efabless/raptor/hardware/raptor_back.jpg

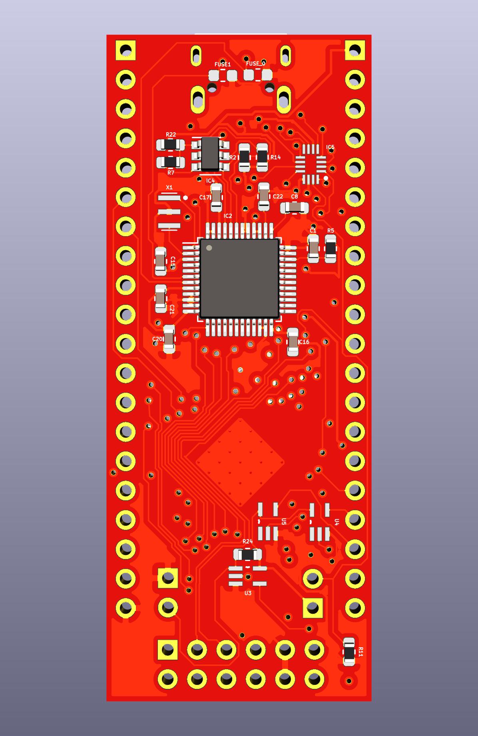
hardware/raptor_back.jpg
