efabless/raptor/hardware/raptor_front.jpg

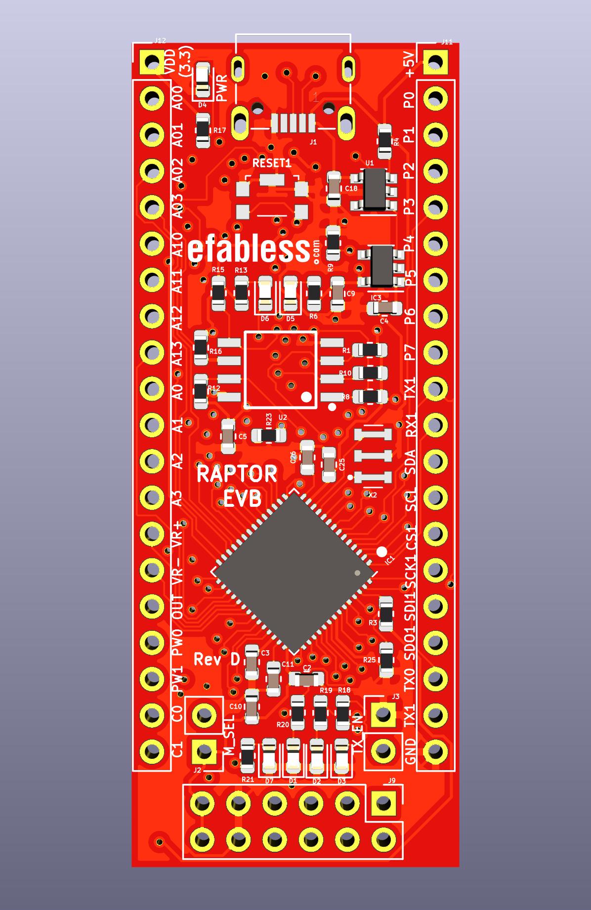
hardware/raptor_front.jpg
