efabless/raptor/hardware/raptor.xlsx

Reference | Quantity | Value | MPN | Vendor | Digikey PN | Link | Footprint
C1 | 1 | 10nf | UMK107B7103KAHT | Taiyo Yuden | 587-5957-1-ND | https://www.digikey.com/product-detail/en/taiyo-yuden/UMK107B7103KAHT/587-5957-1-ND/7675077 | Capacitor_SMD:C_0603_1608Metric
C15 C16 C17 C20 C21 C8 C22 C5 C25 C26 C10 C11 C3 C2 | 14 | 0.1uf | LMF107B7104KAHT | Taiyo Yuden | 587-6557-1-ND | https://www.digikey.com/products/en/capacitors/ceramic-capacitors/60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 | Capacitor_SMD:C_0603_1608Metric
C4 C9 C18 | 3 | 1uf | LMK107C6105KA-T | Taiyo Yuden | 587-4912-1-ND | https://www.digikey.com/product-detail/en/taiyo-yuden/LMK107C6105KA-T/587-4912-1-ND/6563755 | Capacitor_SMD:C_0603_1608Metric
D4 D3 D2 D1 D7 D6 D5 | 7 | LED | 150060RS55040 | Würth Elektronik | 732-12015-1-ND | https://www.digikey.com/products/en?keywords=732-12015-1-ND | LED_SMD:LED_0603_1608Metric
FUSE_0 FUSE1 | 2 | PGB10100603 | PGB1010603NRHF | Littelfuse Inc. | F4239CT-ND | https://www.digikey.com/products/en?keywords=F4239CT-ND | Fuse:Fuse_0603_1608Metric
IC1 | 1 | RAPTORQFN56 | Raptor | Efabless |  |  | Package_DFN_QFN:QFN-56-1EP_8x8mm_P0.5mm_EP5.6x5.6mm_ThermalVias
IC2 | 1 | FT232H | FT232HL-REEL | FTDI, Future Technology Devices International Ltd | 768-1101-1-ND | https://www.digikey.com/product-detail/en/ftdi-future-technology-devices-international-ltd/FT232HL-REEL/768-1101-1-ND/2614632 | Package_QFP:LQFP-48_7x7mm_P0.5mm
IC3 | 1 | MCP1755 | MCP1755T-3302E/OT | Microchip Technology | MCP1755T-3302E/OTCT-ND | https://www.digikey.com/products/en?keywords=MCP1755T-3302E%2FOTCT-ND | Package_TO_SOT_SMD:SOT-23-5
IC4 | 1 | 93C56 | 93C56BT-I/OT | Microchip Technology | 93C56BT-I/OTCT-ND | https://www.digikey.com/products/en?keywords=93C56BT-I%2FOTCT-ND | Package_TO_SOT_SMD:SOT-23-6
IC5 | 1 |  | TMUX1574RSVR | Texas Instruments | 296-53445-1-ND | https://www.digikey.com/products/en/integrated-circuits-ics/interface-analog-switches-multiplexers-demultiplexers/747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 | SamacSys_Parts:QFN40P180X260X55-16N
J1 | 1 | USB | 629105150521 | Würth Elektronik | 732-5960-1-ND | https://www.digikey.com/product-detail/en/w%C3%BCrth-elektronik/629105150521/732-5960-1-ND/5047555 | parts and footprints:629105150521
J11 J12 | 0 | CONN_20 | 68000-220HLF | Amphenol ICC (FCI) | 609-5100-ND | https://www.digikey.com/product-detail/en/amphenol-icc-fci/68000-220HLF/609-5100-ND/4273250 | Connector_PinHeader_2.54mm:PinHeader_1x20_P2.54mm_Vertical
J2 J3 | 0 | Conn_01x02_Male | 77311-118-02LF | Amphenol ICC (FCI) | 609-4434-ND | https://www.digikey.com/product-detail/en/amphenol-icc-fci/77311-118-02LF/609-4434-ND/1523689 | Connector_PinHeader_2.54mm:PinHeader_1x02_P2.54mm_Vertical
J9 | 0 | 2X6 FEMALE | PPPC062LJBN-RC | Sullins Connector Solutions | S5559-ND | https://www.digikey.com/product-detail/en/sullins-connector-solutions/PPPC062LJBN-RC/S5559-ND/776017 | Connector_PinHeader_2.54mm:PinHeader_2x06_P2.54mm_Vertical
R1 R12 R3 R4 R5 R10 R8 R11 R15 R16 R24 | 11 | 10K | ERJ-3EKF1002V | Panasonic Electronic Components | P10.0KHCT-ND | https://www.digikey.com/product-detail/en/panasonic-electronic-components/ERJ-3EKF1002V/P10-0KHCT-ND/198102 | Resistor_SMD:R_0603_1608Metric
R17 R18 R19 R20 R21 R13 R6 | 7 | 150 | RC0603FR-07150RL | Yageo | 311-150HRCT-ND | https://www.digikey.com/product-detail/en/yageo/RC0603FR-07150RL/311-150HRCT-ND/729905 | Resistor_SMD:R_0603_1608Metric
R22 R14 R2 | 3 | 10k | ERJ-3EKF1002V | Panasonic Electronic Components | P10.0KHCT-ND | https://www.digikey.com/product-detail/en/panasonic-electronic-components/ERJ-3EKF1002V/P10-0KHCT-ND/198102 | Resistor_SMD:R_0603_1608Metric
R23 R25 | 2 | 0 | ERJ-3GEY0R00V | Panasonic Electronic Components | P0.0GCT-ND | https://www.digikey.com/products/en/resistors/chip-resistor-surface-mount/52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 | Resistor_SMD:R_0603_1608Metric
R7 | 1 | 2K 1% | ERJ-3EKF2001V | Panasonic Electronic Components | P2.00KHCT-ND | https://www.digikey.com/product-detail/en/panasonic-electronic-components/ERJ-3EKF2001V/P2-00KHCT-ND/198219 | Resistor_SMD:R_0603_1608Metric
R9 | 1 | 12K 1% | ERJ-3EKF1202V | Panasonic Electronic Components | P12.0KHCT-ND | https://www.digikey.com/product-detail/en/panasonic-electronic-components/ERJ-3EKF1202V/P12-0KHCT-ND/1746728 | Resistor_SMD:R_0603_1608Metric
RESET1 | 1 | SPST-SMD-4.6X2.8mm | KMR421G LFS | C&K | CKN10249CT-ND | https://www.digikey.com/product-detail/en/c-k/KMR421G-LFS/CKN10249CT-ND/2176500 | SamacSys_Parts:TL6330AF200Q
U1 | 1 | MCP1316M | MCP1316MT-20LI/OT | Microchip Technology | MCP1316MT-20LI/OTCT-ND | https://www.digikey.com/products/en?keywords=MCP1316MT-20LI%2FOTCT-ND | Package_TO_SOT_SMD:SOT-23-5
U2 | 1 | W25Q32FV | W25Q32JVSSIQ TR | Winbond Electronics | W25Q32JVSSIQCT-ND | https://www.digikey.com/products/en?keywords=W25Q32JVSSIQCT-ND | parts and footprints:SOIC127P790X216-8N
U3 | 1 |  | SN74LVC1G125DCKR | Texas Instruments | 296-11604-1-ND | https://www.digikey.com/products/en/integrated-circuits-ics/logic-buffers-drivers-receivers-transceivers/704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
U4, U5 | 2 |  | SN74LV1T34DCKR | Texas Instruments | 296-37177-1-ND
X1 | 1 | 12MHz | CSTNE12M0GH5L000R0 | Murata Electronics | 490-17947-1-ND | https://www.digikey.com/products/en/crystals-oscillators-resonators/resonators/174?k=CSTNE12M0GH5L000R0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 | SamacSys_Parts:CSTNE12M0GH5L000R0
X2 | 1 | 6.25 MHz | CSTCR6M25G55B-R0 | Murata Electronics
