efabless/raptor/hardware/raptor.pdf

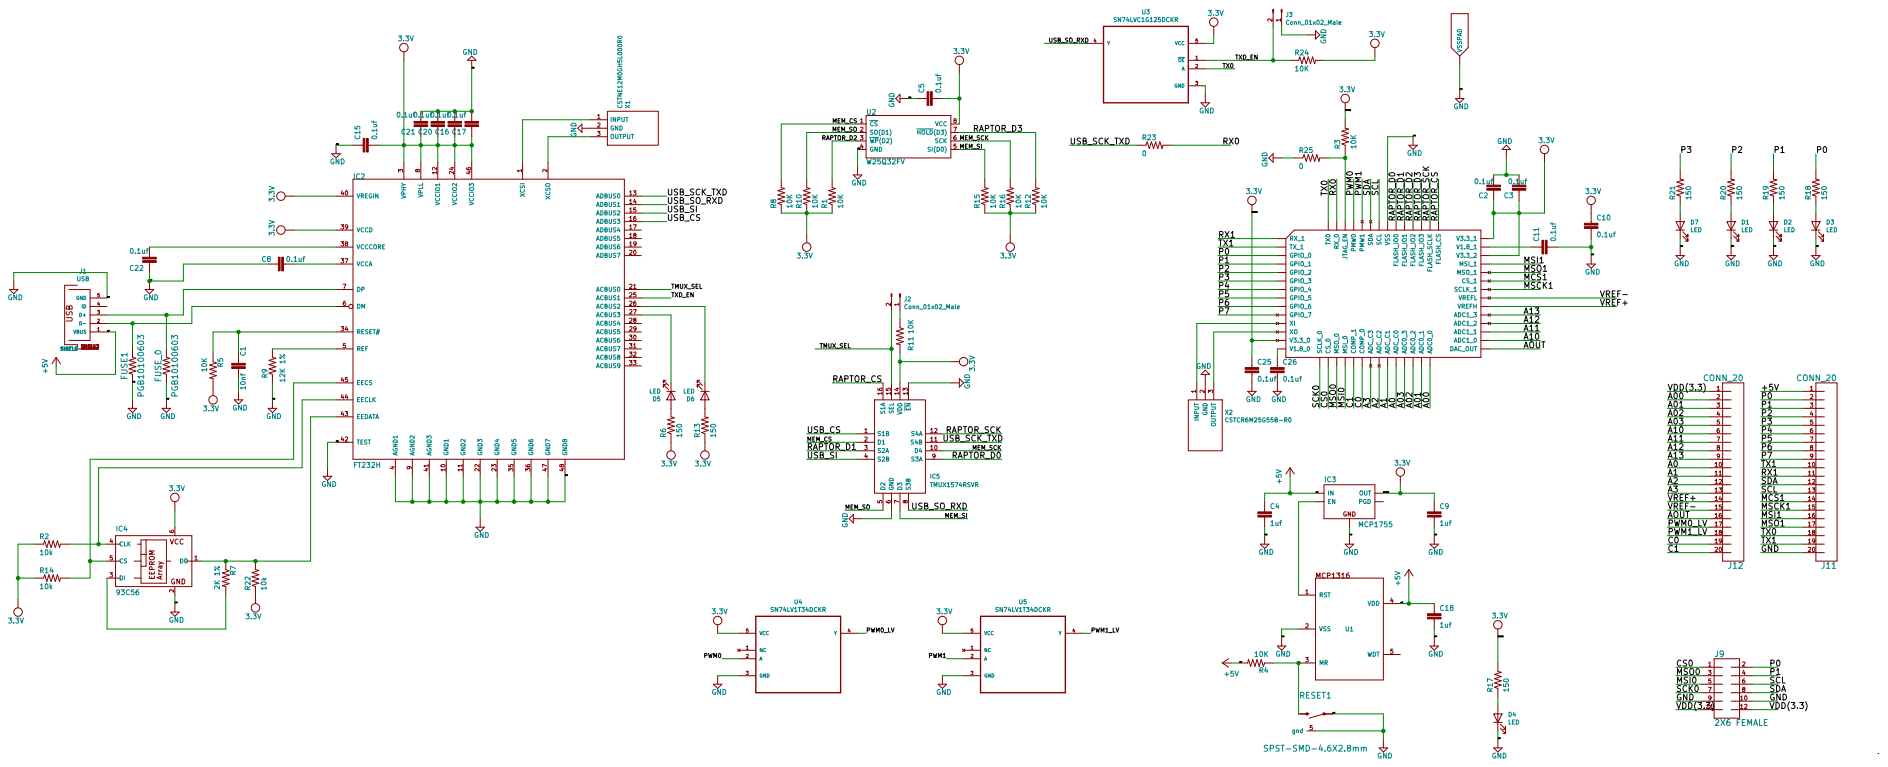
[picture p4: page 1]

4 VREGIN 40 AGND3 41 TEST 42 EEDATA 43 EECLK 44 EECS 45 VCCIO3 46 GND7 47 GND8 48 REF 5 DM 6 DP 7 VPLL

3 ACBUS6 30 ACBUS7 31 ACBUS8 32 ACBUS9 33 RESET# 34 GND5 35 GND6 36 VCCA 37 VCCCORE 38 VCCD 39 AGND1
