efabless/raptor/hardware/raptor.kicad_pcb

## KiCad design hardware/raptor.kicad_pcb (2020-08-08)

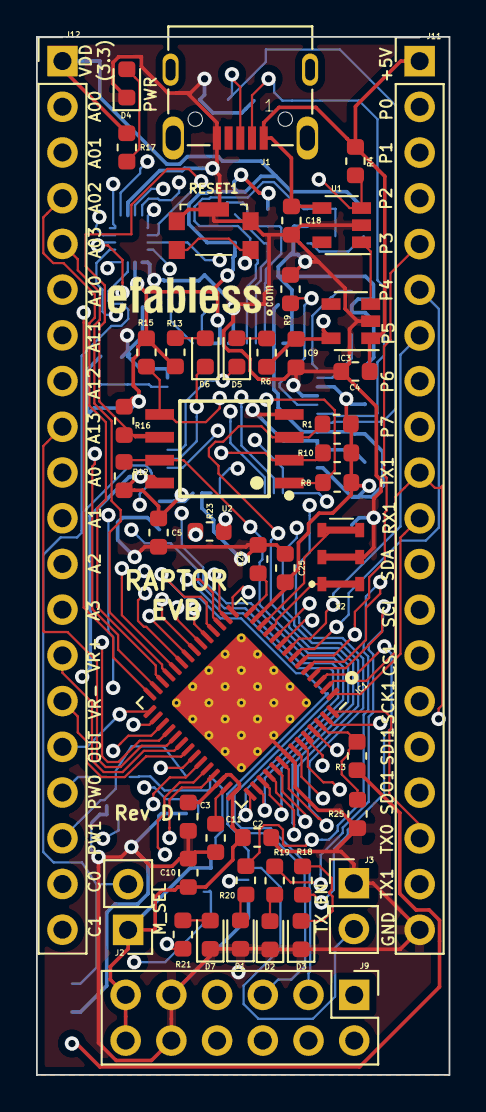
[picture p5: board raptor.kicad_pcb from above]

Board: 4 copper layers, 22.9 x 57.7 mm, 72 parts (0 on the bottom side), 91 nets.

Parts:
C1: 10nf; C_0603_1608Metric
C2, C3, C5, C8, C10, C11, C15, C16, C17, C20, C21, C22, C25, C26: 0.1uf; C_0603_1608Metric
C4, C9, C18: 1uf; C_0603_1608Metric
D1, D2, D3, D4, D5, D6, D7: LED; LED_0603_1608Metric
FUSE1: PGB10100603; Fuse_0603_1608Metric
FUSE_0: PGB10100603; Fuse_0603_1608Metric
G1: LOGO; logo
IC1: RAPTORQFN56; QFN-56-1EP_8x8mm_P0.5mm_EP5.6x5.6mm_ThermalVias
IC2: FT232H; LQFP-48_7x7mm_P0.5mm
IC3: MCP1755; SOT-23-5
IC4: 93C56; SOT-23-6
IC5: TMUX1574RSVR; QFN40P180X260X55-16N
J1: USB; 629105150521
J2, J3: Conn_01x02_Male; PinHeader_1x02_P2.54mm_Vertical
J9: 2X6 FEMALE; PinHeader_2x06_P2.54mm_Vertical
J11, J12: CONN_20; PinHeader_1x20_P2.54mm_Vertical
R1, R3, R4, R5, R8, R10, R11, R12, R15, R16, R24: 10K; R_0603_1608Metric
R2, R14, R22: 10k; R_0603_1608Metric
R6, R13, R17, R18, R19, R20, R21: 150; R_0603_1608Metric
R7: 2K 1%; R_0603_1608Metric
R9: 12K 1%; R_0603_1608Metric
R23, R25: 0; R_0603_1608Metric
RESET1: SPST-SMD-4.6X2.8mm; TL6330AF200Q
U1: MCP1316M; SOT-23-5
U2: W25Q32FV; SOIC127P790X216-8N
U3: SN74LVC1G125DCKR; SOT65P210X110-5N
U4, U5: SN74LV1T34DCKR; SOT65P210X110-5N
X1: CSTNE12M0GH5L000R0
X2: CSTCR6M25G55B-R0; CSTCR6M25G55BR0

Connections:
+5V: C4.1, C18.1, IC3.1, J1.1, J11.1, R4.2, U1.4
/A00: IC1.28, J12.2
/A0: IC1.24, J12.10
/A01: IC1.27, J12.3
/A1: IC1.23, J12.11
/A02: IC1.26, J12.4
/A2: IC1.22, J12.12
/A03: IC1.25, J12.5
/A3: IC1.21, J12.13
/A10: IC1.30, J12.6
/A11: IC1.31, J12.7
/A12: IC1.32, J12.8
/A13: IC1.33, J12.9
/AOUT: IC1.29, J12.16
/C0: IC1.20, J12.19
/C1: IC1.19, J12.20
/CS0: IC1.16, J9.1
/MCS1: IC1.37, J11.14
/MEM_CS: IC5.2, R8.2, U2.1
/MEM_SCK: IC5.10, R16.2, U2.6
/MEM_SI: IC5.7, R15.2, U2.5
/MEM_SO: IC5.5, R10.2, U2.2
/MSCK1: IC1.36, J11.15
/MSI0: IC1.18, J9.5
/MSI1: IC1.39, J11.16
/MSO0: IC1.17, J9.3
/MSO1: IC1.38, J11.17
/P0: IC1.3, J9.2, J11.2, R18.2
/P1: IC1.4, J9.4, J11.3, R19.2
/P2: IC1.5, J11.4, R20.2
/P3: IC1.6, J11.5, R21.2
/P4: IC1.7, J11.6
/P5: IC1.8, J11.7
/P6: IC1.9, J11.8
/P7: IC1.10, J11.9
/PWM0: IC1.53, U4.2
/PWM0_LV: J12.17, U4.4
/PWM1: IC1.52, U5.2
/PWM1_LV: J12.18, U5.4
/RAPTOR_CS: IC1.43, IC5.16
/RAPTOR_D0: IC1.48, IC5.9
/RAPTOR_D1: IC1.47, IC5.3
/RAPTOR_D2: IC1.46, R1.2, U2.3
/RAPTOR_D3: IC1.45, R12.2, U2.7
/RAPTOR_SCK: IC1.44, IC5.12
/RX0: IC1.55, R23.2
/RX1: IC1.1, J11.11
/SCK0: IC1.15, J9.7
/SCL: IC1.50, J9.6, J11.13
/SDA: IC1.51, J9.8, J11.12
/TMUX_SEL: IC2.21, IC5.15, J2.2, R11.1
/TX0: IC1.56, J11.18, U3.2
/TX1: IC1.2, J11.10, J11.19
/TXD_EN: IC2.25, J3.2, R24.1, U3.1
/USB_CS: IC2.16, IC5.1
/USB_SCK_TXD: IC2.13, IC5.11, R23.1
/USB_SI: IC2.15, IC5.4
/USB_SO_RXD: IC2.14, IC5.8, U3.4
/VREF+: IC1.34, J12.14
/VREF-: IC1.35, J12.15
GND: C1.2, C2.2, C3.2, C4.2, C5.1, C8.1, C9.2, C10.2, C11.2, C15.1, C16.2, C17.2, C18.2, C20.2, C21.2, C22.1, C25.2, C26.2, D1.1, D2.1, D3.1, D4.1, D7.1, FUSE1.1, FUSE_0.1, IC1.49, IC1.57, IC2.4, IC2.9, IC2.10, IC2.11, IC2.22, IC2.23, IC2.35, IC2.36, IC2.41, IC2.42, IC2.47, IC2.48, IC3.2, IC4.2, IC5.6, IC5.13, J1.5, J3.1, J9.9, J9.10, J11.20, R9.1, R11.2, R25.1, RESET1.1, RESET1.2, RESET1.5, U1.2, U2.4, U3.3, U4.3, U5.3, X1.2, X2.2
unnamed: C1.1, IC2.34, R5.1
unnamed: C8.2, IC2.37
unnamed: C11.1, IC1.41
unnamed: C22.2, IC2.38
unnamed: C26.1, IC1.14
unnamed: D1.2, R20.1
unnamed: D2.2, R19.1
unnamed: D3.2, R18.1
unnamed: D4.2, R17.1
unnamed: D5.1, IC2.27
unnamed: D5.2, R6.2
unnamed: D6.1, IC2.26
unnamed: D6.2, R13.2
unnamed: D7.2, R21.1
unnamed: FUSE1.2, IC2.6, J1.2
unnamed: FUSE_0.2, IC2.7, J1.3
unnamed: IC1.11, X2.1
unnamed: IC1.12, X2.3
unnamed: IC1.54, R3.1, R25.2
unnamed: IC2.1, X1.1
unnamed: IC2.2, X1.3
unnamed: IC2.5, R9.2
unnamed: IC2.43, IC4.1, R7.1, R22.2
unnamed: IC2.44, IC4.4, R2.2
unnamed: IC2.45, IC4.5, R14.2
unnamed: IC3.3, U1.1
unnamed: IC4.3, R7.2
unnamed: J1.SHELL, J1.SHELL1, J1.SHELL2, J1.SHELL3
unnamed: R4.1, RESET1.3, RESET1.4, U1.3
VDD: C2.1, C3.1, C5.2, C9.1, C10.1, C15.2, C16.1, C17.1, C20.1, C21.1, C25.1, IC1.13, IC1.40, IC1.42, IC2.3, IC2.8, IC2.12, IC2.24, IC2.39, IC2.40, IC2.46, IC3.5, IC4.6, IC5.14, J2.1, J9.11, J9.12, J12.1, R1.1, R2.1, R3.2, R5.2, R6.1, R8.1, R10.1, R12.1, R13.1, R14.1, R15.1, R16.1, R17.2, R22.1, R24.2, U2.8, U3.5, U4.5, U5.5
