efabless/raptor/firmware/i2c/i2c.c

#include "../raptor.h"
#include "../raptor_io.h"

#define BCD_DIGIT0(x) (x & (uint32_t)0x000F)
#define BCD_DIGIT1(x) ((x >> 4) & (uint32_t)0x000F)

#define RTC_I2C_ADDR (uint32_t) 0xA2 // RTC PCF8563
#define RTC_I2C_REG (uint32_t) 0x02 // RTC PCF8563

//#define RTC_I2C_ADDR (uint32_t)0xD0 // RTC DS3231
//#define RTC_I2C_REG (uint32_t) 0x00 // RTC DS3231

//#define RTC_I2C_ADDR (uint32_t) 0xDE // RTC MCP79410
//#define RTC_I2C_REG (uint32_t) 0x00 // RTC MCP79410

//unsigned char data[4];


void main()
{
//	uint32_t i, j;
	int i, j;
	int x, v, y;
    unsigned char data[2];

//    set_clock(true, true, 16);

    // Enable GPIO (all output, ena = 0)
//	gpio_set_dir(0x0000);
//    gpio_write(0x000f);
    reg_gpio_dir = 0x0000;
    reg_gpio_data = 0x0f;

//    for (j = 0; j < 70000; j++);

//    print("Starting...");
    i2c_init(19);
    y = 0;

    while (1) {
//        i2c_send_byte(0xa2, 0x02);
//        gpio_write(0x000a);
        if (i2c_read_bytes(RTC_I2C_ADDR, RTC_I2C_REG, data, 3)){
//            i2c_read_bytes(0xa2, 0x02, data, 3);
//        if (data[0] = i2c_read_byte(RTC_I2C_ADDR, RTC_I2C_REG)){
//           data[0] = i2c_read_bytes(0xa2, 0x02);
//        y = i2c_read_byte_1(0xa2, 0x02, data);
//        print_hex(y,6);
//        data[0] = y & 0x7f;
//        data[1] = (y >> 8) & 0x7f;
//        data[2] = (y >> 16) & 0x3f;
//            print_hex(data[0], 2);
//            data[0] &= ((unsigned char) 0x007F);
//            data[1] &= ((unsigned char) 0x007F);
//            data[2] &= ((unsigned char) 0x003F);
//            print_digit(BCD_DIGIT1(data[0]));
//            print_digit(BCD_DIGIT0(data[0]));
//            print(":");
//            print_digit(BCD_DIGIT1(data[1]));
//            print_digit(BCD_DIGIT0(data[1]));
//            print(":");
//            print_digit(BCD_DIGIT1(data[2]));
//            print_digit(BCD_DIGIT0(data[2]));
//            print("\n");
//            gpio_write(data[0]);

//        print_hex(data[1], 2); print(":");
//        print_hex(data[2], 2);
        } else {
//            gpio_write(0x09);
            reg_gpio_data = 0x09;
        }
//        gpio_write(0x05);
        reg_gpio_data = 0x05;

        while(1);
//        for (j = 0; j < 700000; j++) {
//            gpio_write(0x05);
//        } // 2 sec
//        gpio_write(0x05);
//        for (j = 0; j < 70000; j++) {} // 2 sec
    }

}
