efabless/raptor/firmware/sw/tmr_regs.h

#include "base_addr.h"
#include "macros.h"


#define     TMR_REG             0x00000000
#define     TMR_PRE_REG         0x00000004
#define     TMR_CMP_REG         0x00000008
#define     TMR_STATUS_REG      0x00000010
#define     TMR_CTRL_REG        0x00000020

// STATUS register fields
#define     TMR_OV_BIT          0x0
#define     TMR_OV_SIZE         0x1

// CTRL register fields
#define     TMR_OVCLR_BIT       0x0
#define     TMR_OVCLR_SIZE      0x1
#define     TMR_EN_BIT          0x1
#define     TMR_EN_SIZE         0x1



unsigned int volatile * const TMR_CTRL = (unsigned int *) (TIMER_BASE_ADDR_0 + TMR_CTRL_REG);
unsigned int volatile * const TMR = (unsigned int *) (TIMER_BASE_ADDR_0 + TMR_REG);
unsigned int volatile * const TMR_STATUS = (unsigned int *) (TIMER_BASE_ADDR_0 + TMR_STATUS_REG);
unsigned int volatile * const TMR_PRE = (unsigned int *) (TIMER_BASE_ADDR_0 + TMR_PRE_REG);
unsigned int volatile * const TMR_CMP = (unsigned int *) (TIMER_BASE_ADDR_0 + TMR_CMP_REG);
