efabless/raptor/(commit log)

2020-01-26 update PID for raptor FTDI
2020-02-05 blink = led test
2020-03-10 add uart test
2020-03-17 added hardware and gitignore
    [raptor.kicad_pcb, raptor.sch]
2020-03-19 update schematic
    [raptor.sch]
2020-03-24 adjusted logo on silkscreen
    [raptor-B_Mask.gbs, raptor-B_SilkS.gbo, raptor-Bottom.gbl, raptor-Edge_Cuts.gm1, raptor-F_Mask.gts, raptor-F_SilkS.gto, raptor-Top.gtl, raptor.drl]
2020-03-24 Revert "adjusted logo on silkscreen"
    This reverts commit 2ac67c38
    [raptor-B_Mask.gbs, raptor-B_SilkS.gbo, raptor-Bottom.gbl, raptor-Edge_Cuts.gm1, raptor-F_Mask.gts, raptor-F_SilkS.gto, raptor-Top.gtl, raptor.drl]
2020-03-24 update logo and silkscreen (2)
    [raptor-B_Fab.gbr, raptor-B_Mask.gbs, raptor-B_Paste.gbp, raptor-B_SilkS.gbo, raptor-Bottom.gbl, raptor-Edge_Cuts.gm1, raptor-F_Fab.gbr, raptor-F_Mask.gts]
2020-04-01 recommit previous version
    [raptor.kicad_pcb]
2020-04-01 updated cut layer to include slots
    [raptor-B_Fab.gbr, raptor-B_Mask.gbs, raptor-B_Paste.gbp, raptor-B_SilkS.gbo, raptor-Bottom.gbl, raptor-Edge_Cuts.gm1, raptor-F_Fab.gbr, raptor-F_Mask.gts]
2020-04-30 uart complete
2020-05-01 adc first pass working
2020-05-01 i2c + updated to flash
2020-05-06 completed dac and spi testing
2020-05-06 completed pwm testing
2020-06-26 raptor hardware rev c
    [raptor-B_Fab.gbr, raptor-B_Mask.gbs, raptor-B_Paste.gbp, raptor-B_SilkS.gbo, raptor-Bottom.gbl, raptor-Edge_Cuts.gm1, raptor-F_Fab.gbr, raptor-F_Mask.gts]
2020-07-01 updated blink and i2c with workaround fix
    [SoC.tb.v, blink.c, i2c.c, i2c_drv.c]
2020-08-08 updated raptor evb rev d
    [raptor-B_Fab.gbr, raptor-B_Mask.gbs, raptor-B_Paste.gbp, raptor-B_SilkS.gbo, raptor-Bottom.gbl, raptor-Edge_Cuts.gm1, raptor-F_Fab.gbr, raptor-F_Mask.gts]
2020-09-05 updated files
    [raptor.xlsx]
2020-11-04 change to raptor.c; added functions to set clock using int and ext osc
    [raptor.xlsx]
